shujima/type-c-card/schematic.pdf

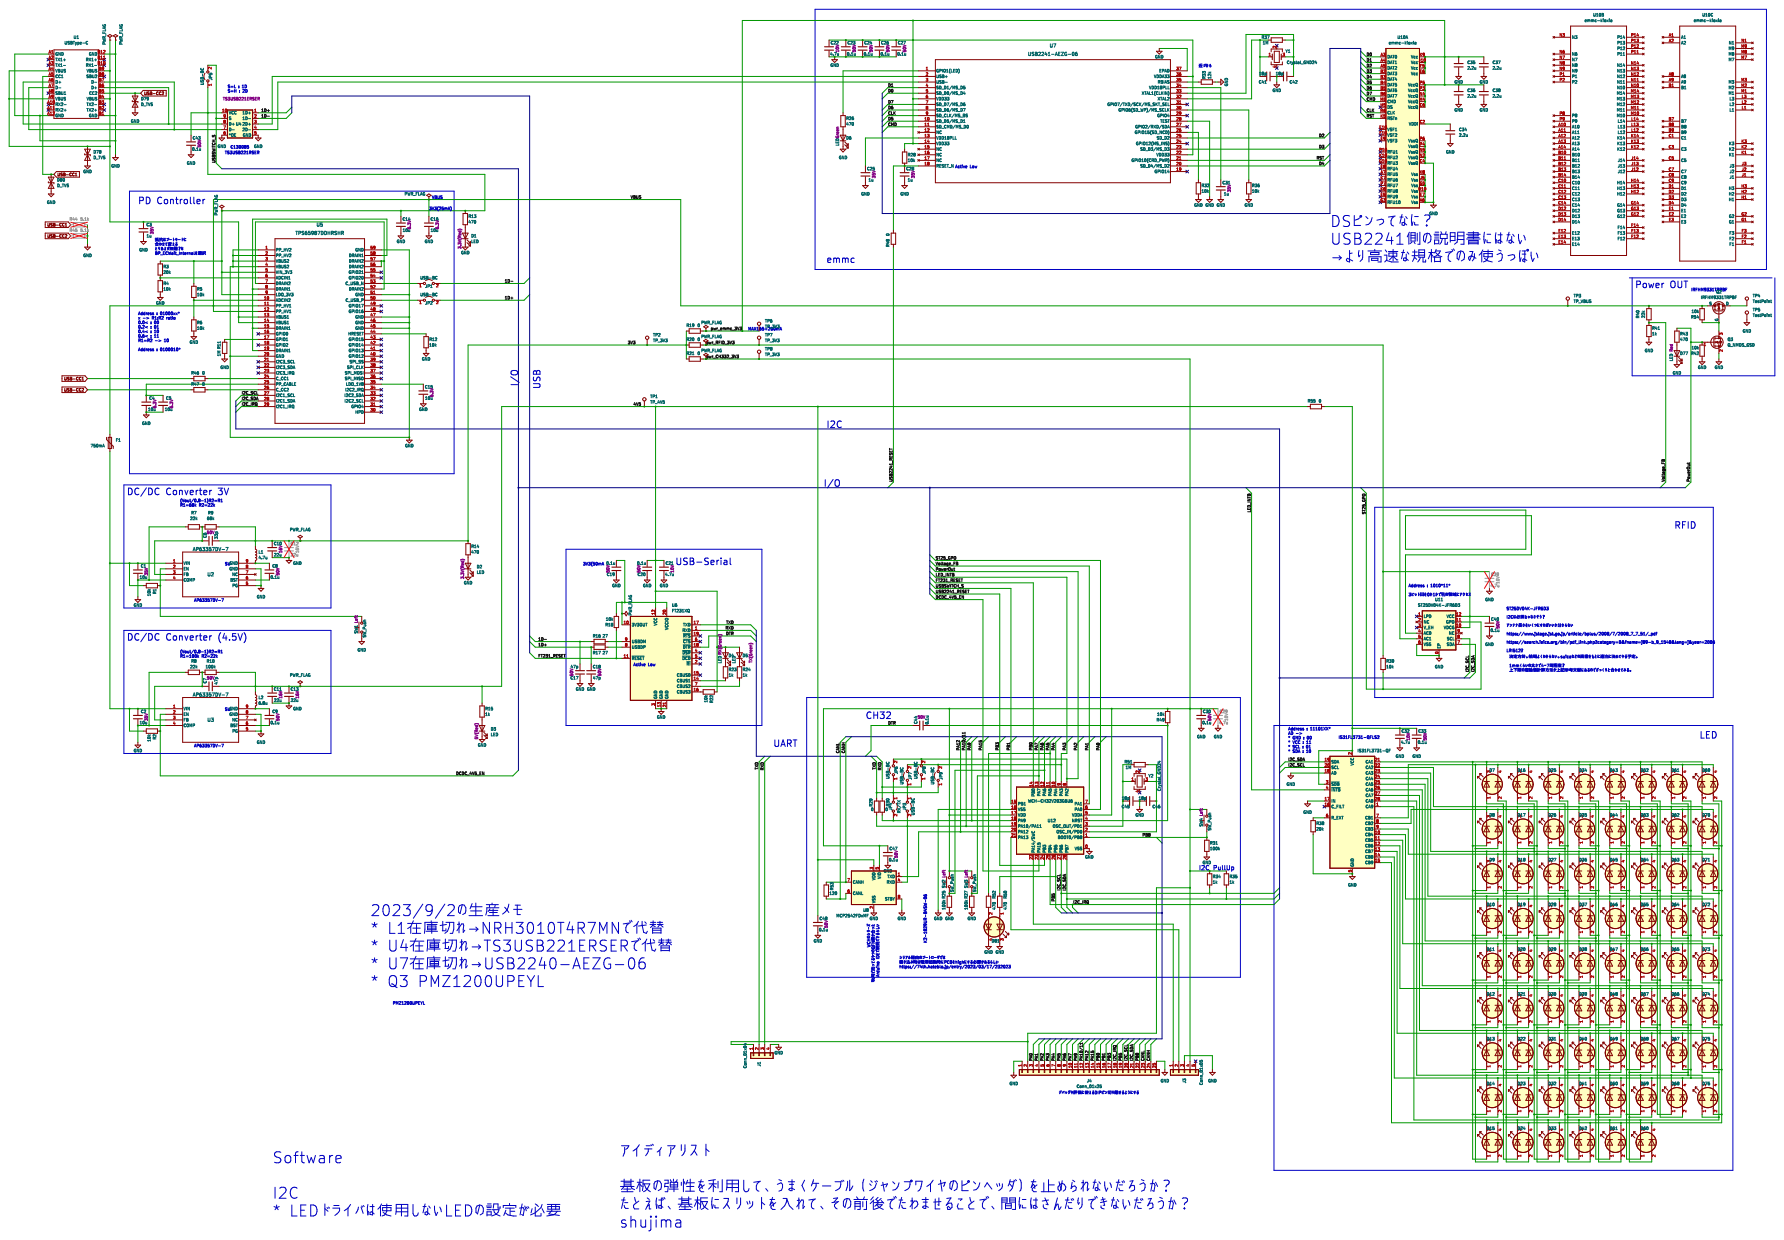
[picture p6: page 1]
