shujima/type-c-card/hardware/sample/type-c-card_lexxpluss_2023/exports/type-c-card_lexxpluss_2023.pdf

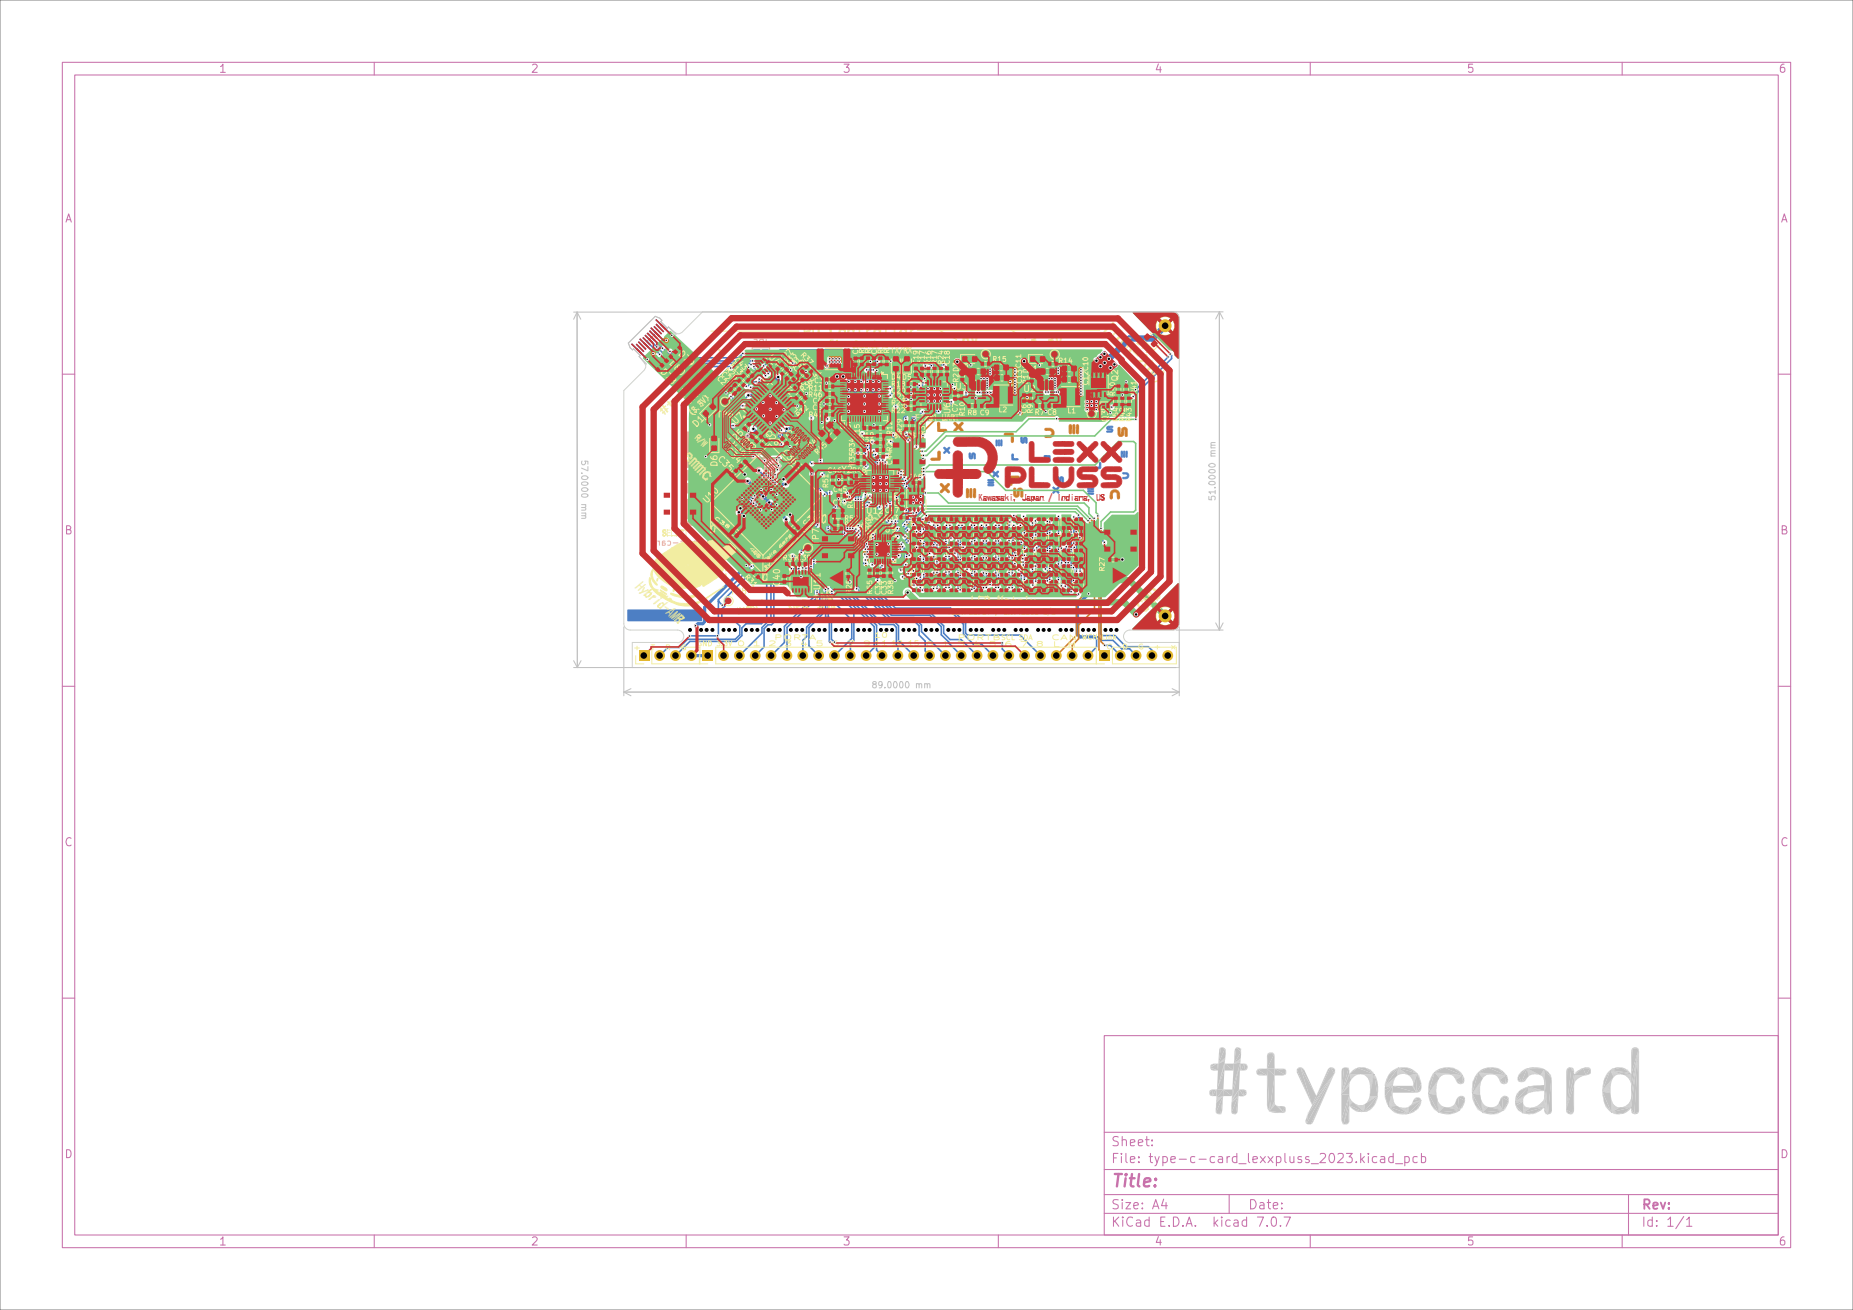
[picture p7: page 1]
