shujima/type-c-card/hardware/sample/type-c-card_lexxpluss_2023/type-c-card_lexxpluss_2023.kicad_sch

## KiCad design hardware/sample/type-c-card_lexxpluss_2023/type-c-card_lexxpluss_2023.kicad_sch (2023-09-23)

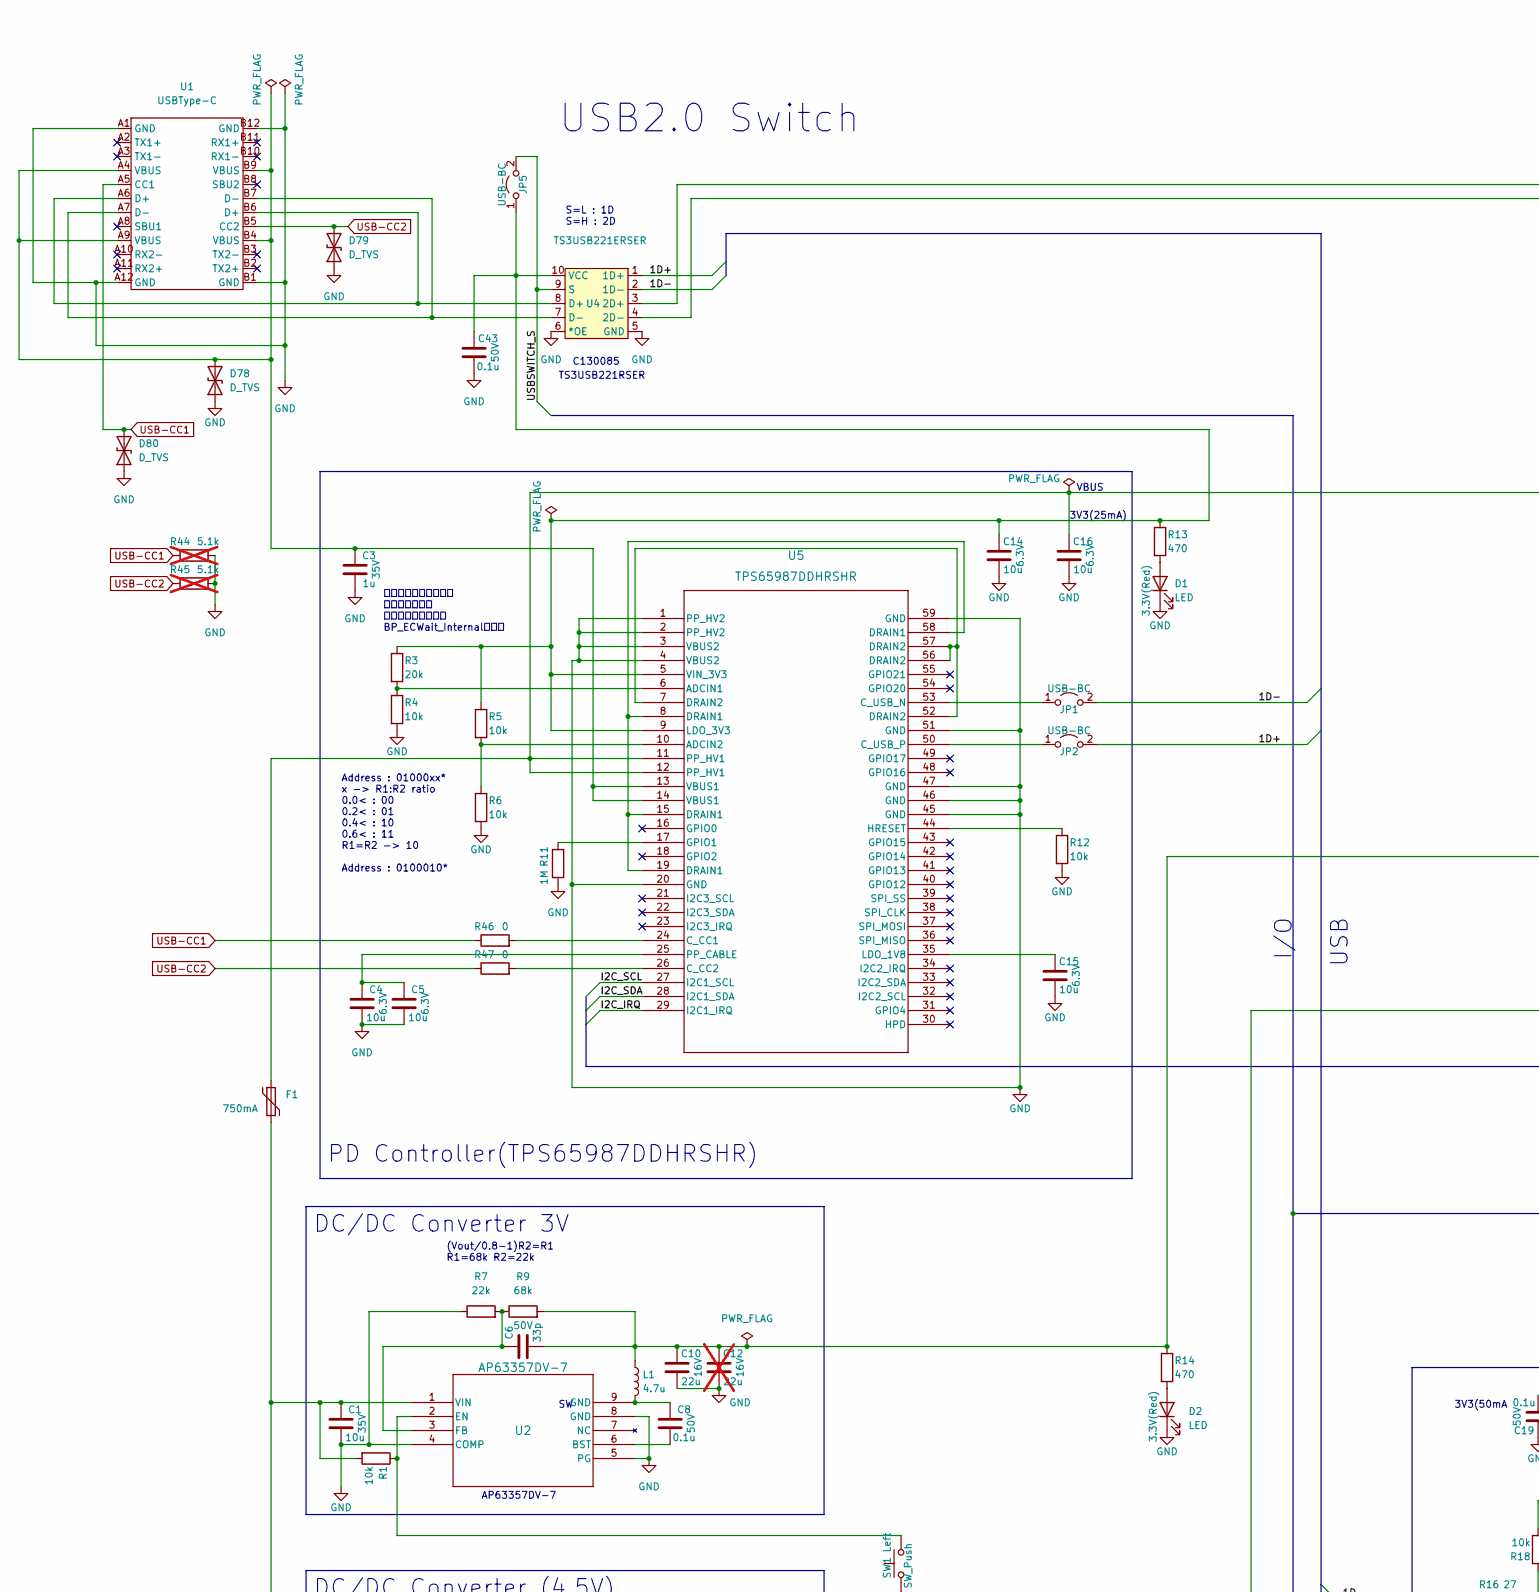
[picture p8: schematic type-c-card_lexxpluss_2023.kicad_sch, part in row 1, column 1]

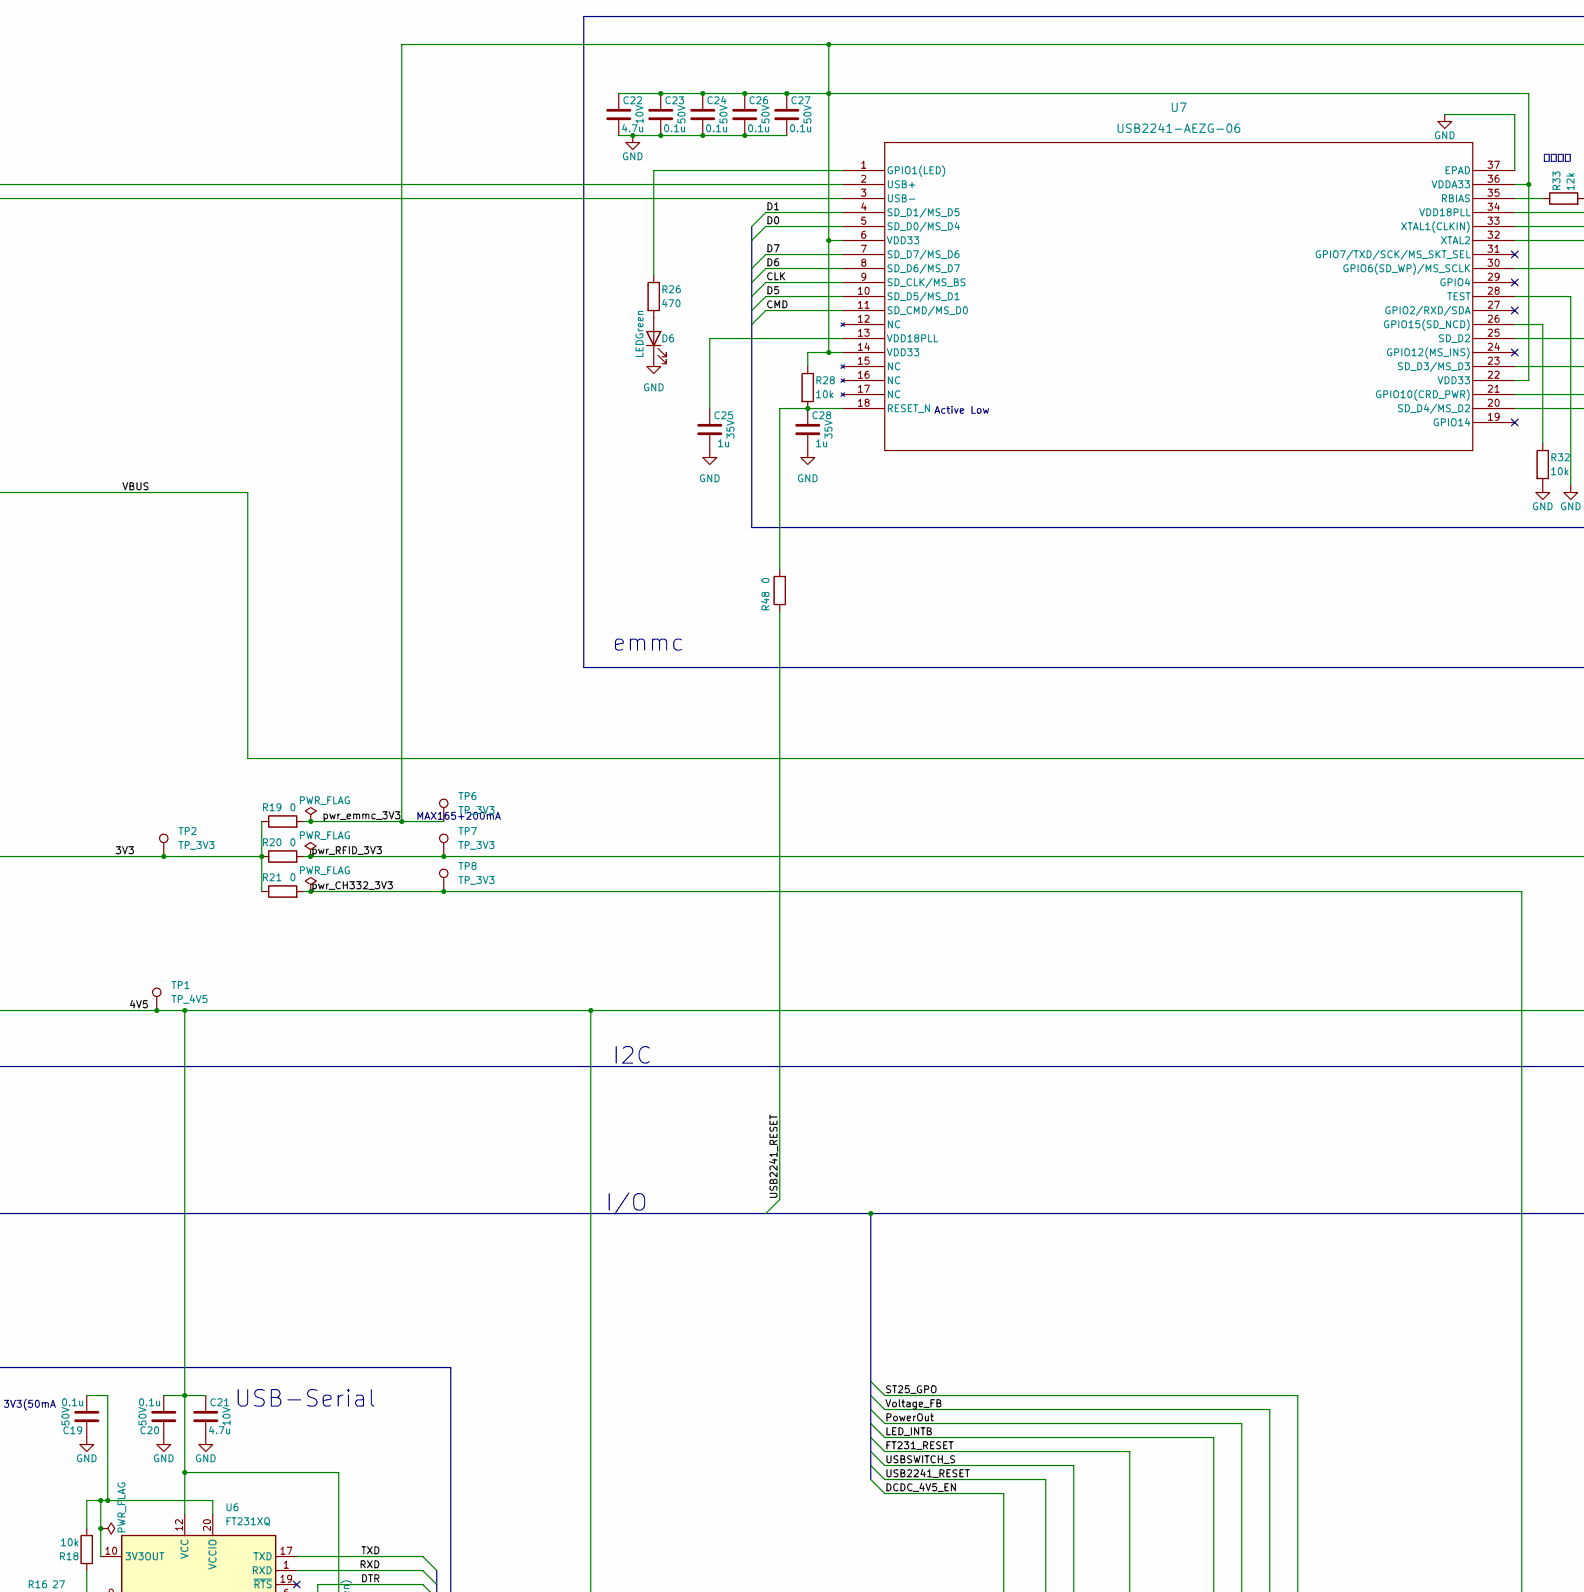
[picture p9: schematic type-c-card_lexxpluss_2023.kicad_sch, part in row 1, column 2]

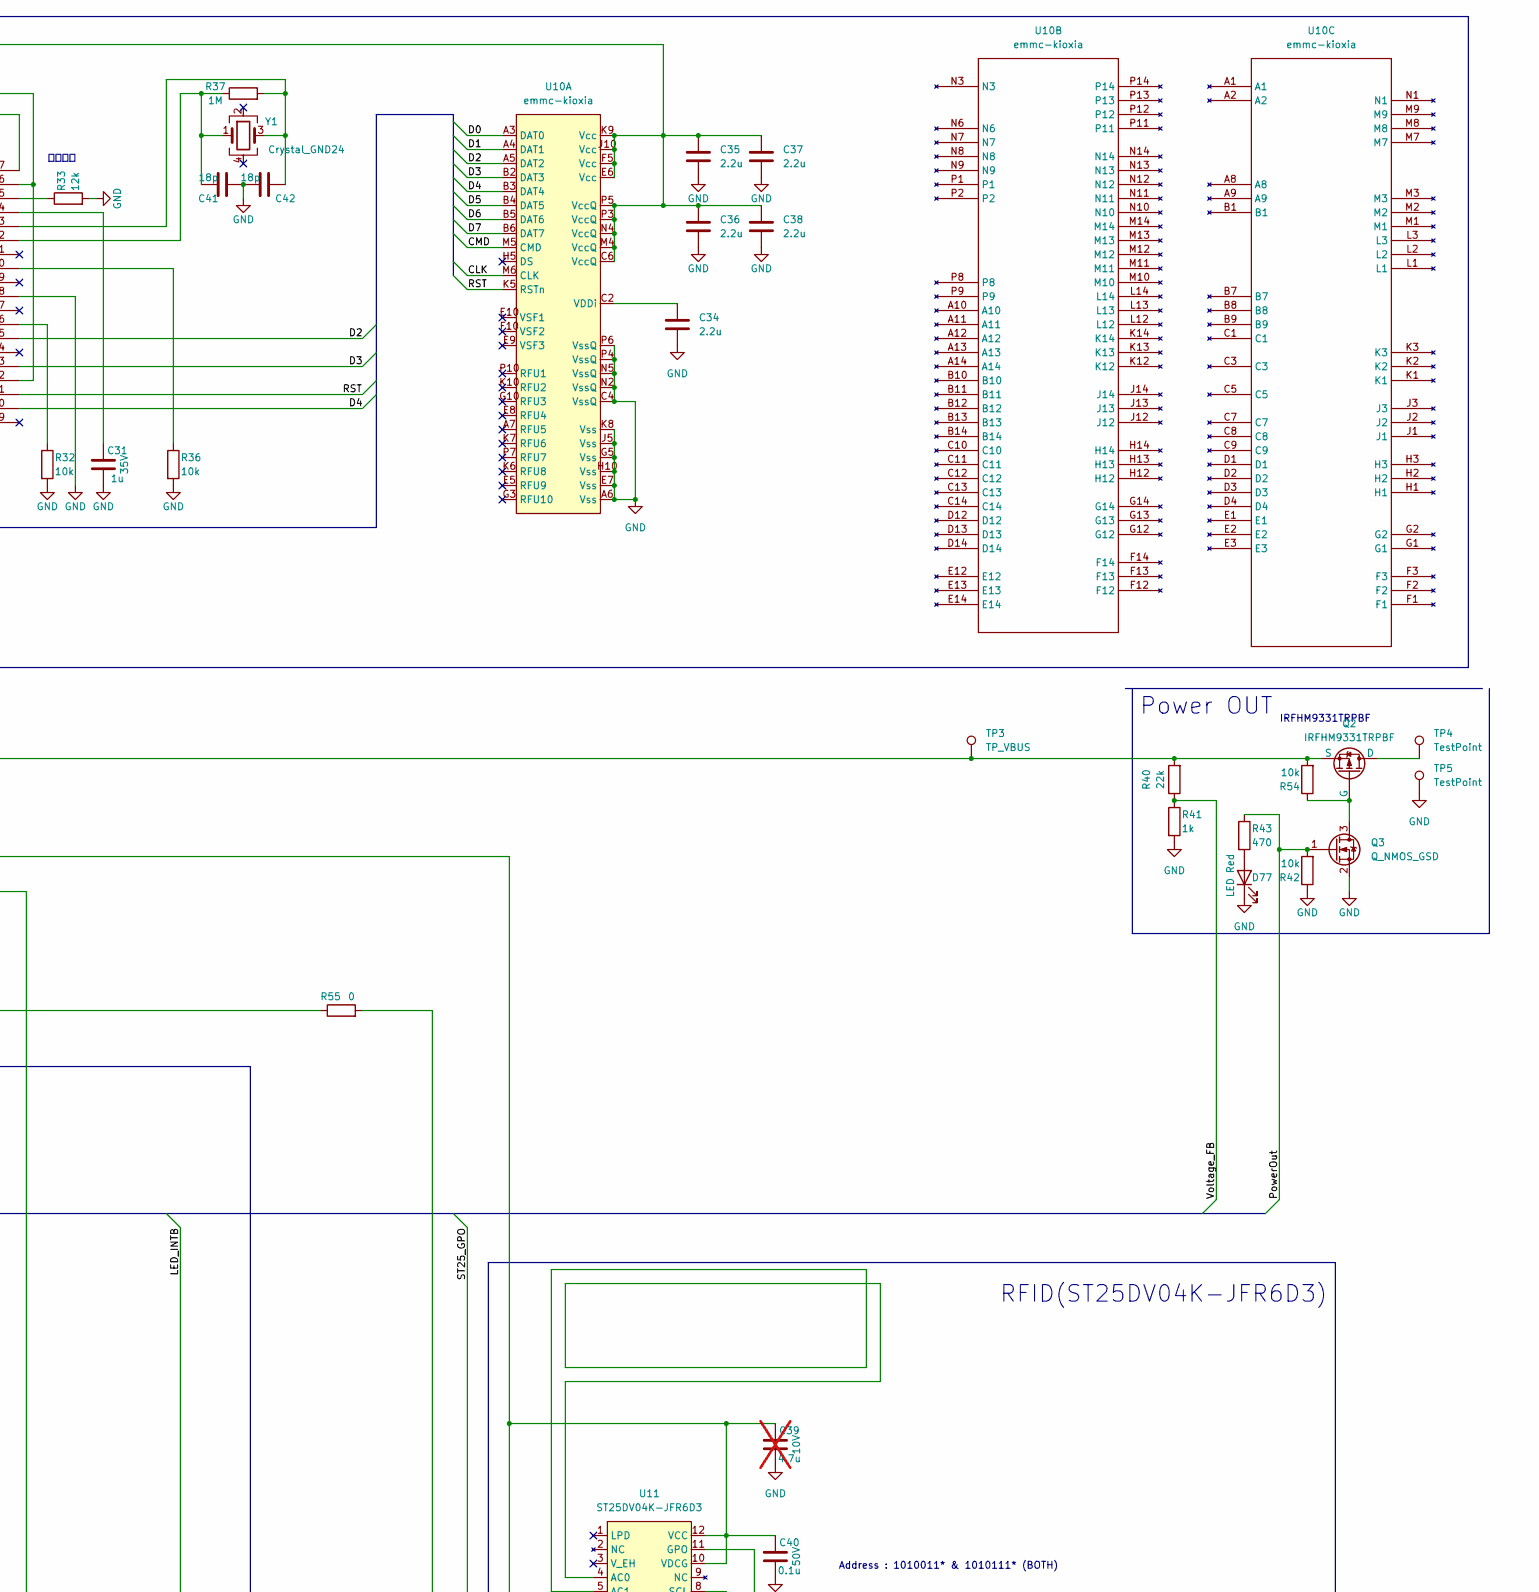
[picture p10: schematic type-c-card_lexxpluss_2023.kicad_sch, part in row 1, column 3]

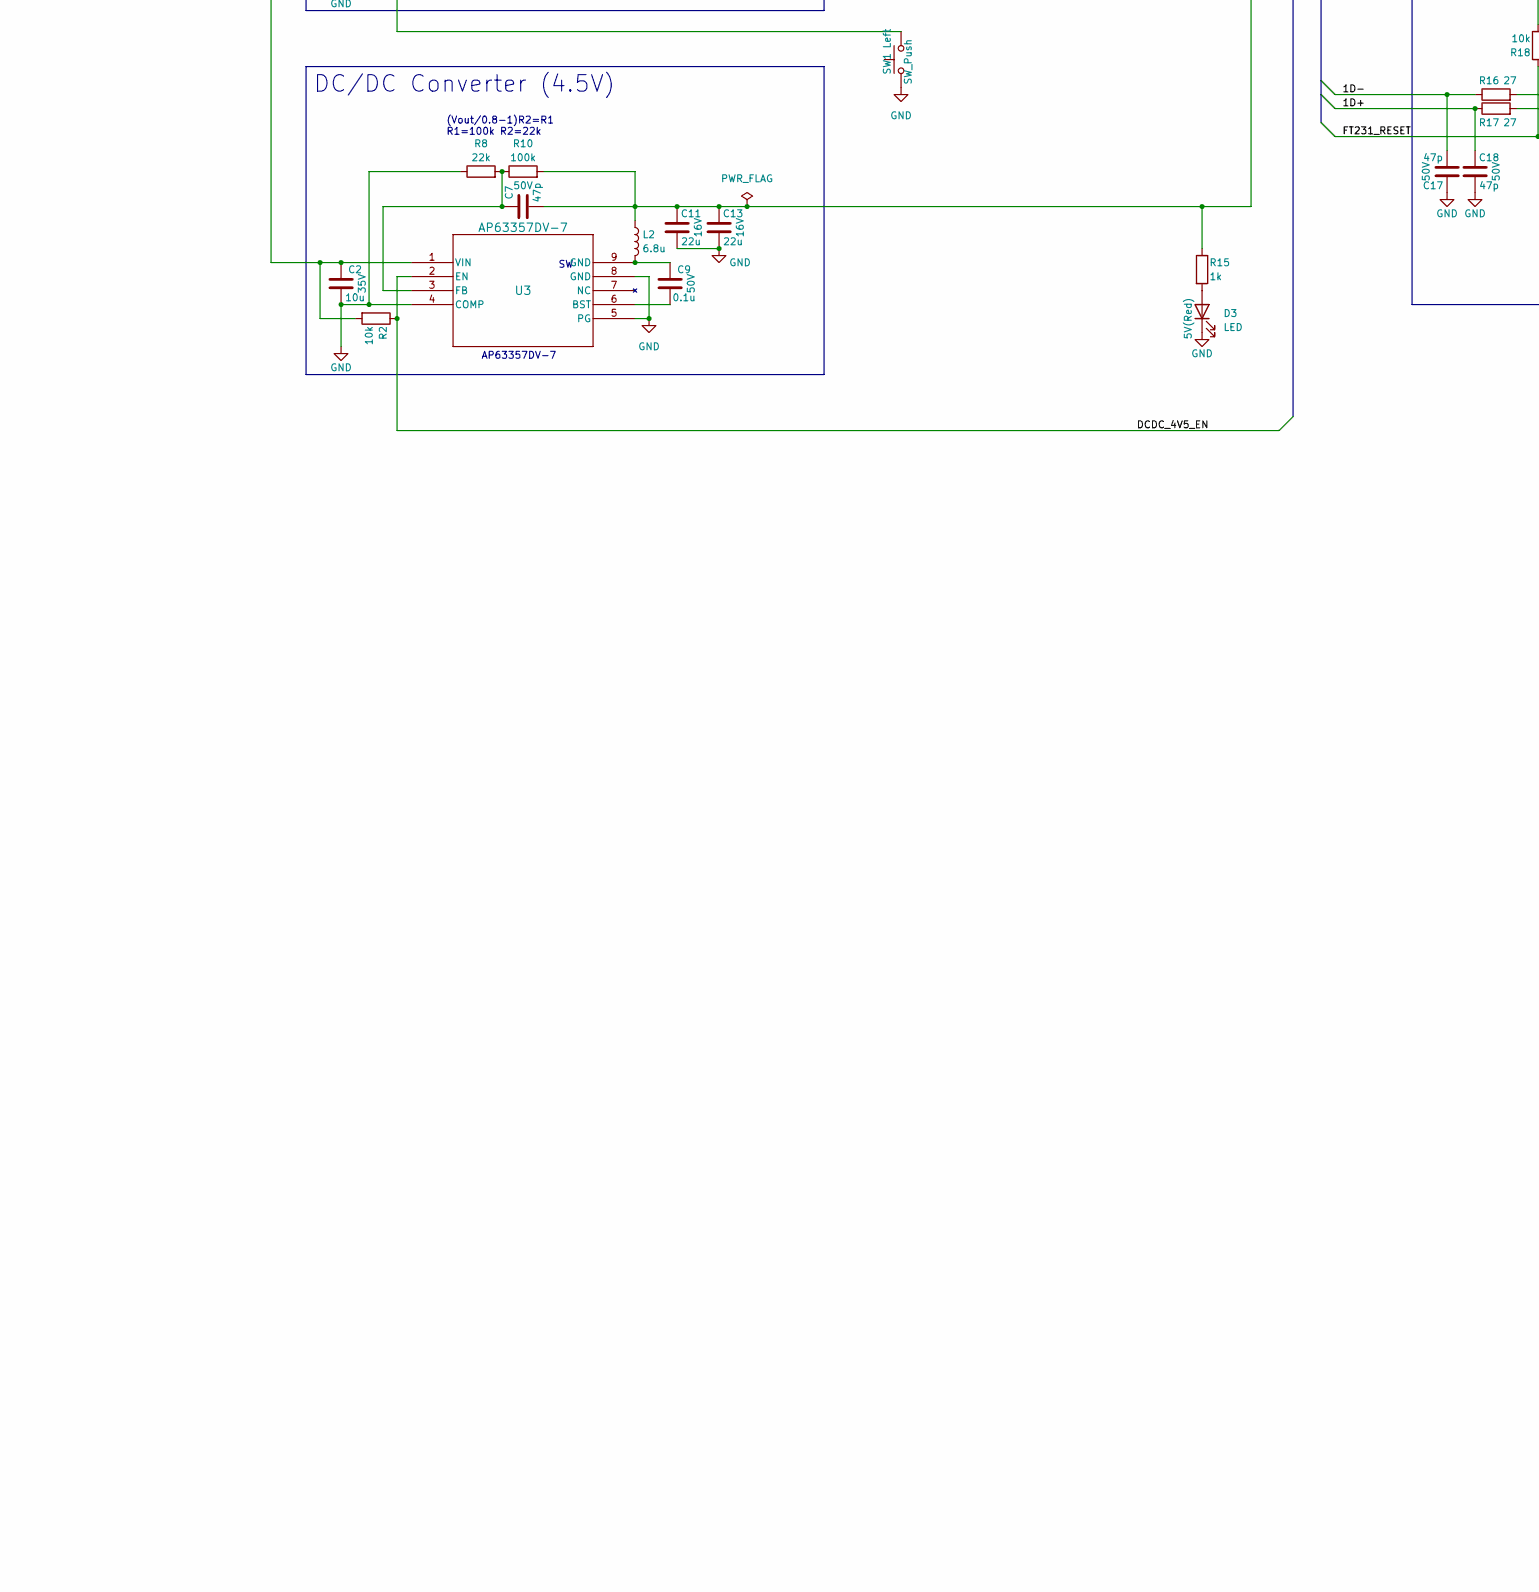
[picture p11: schematic type-c-card_lexxpluss_2023.kicad_sch, part in row 2, column 1]

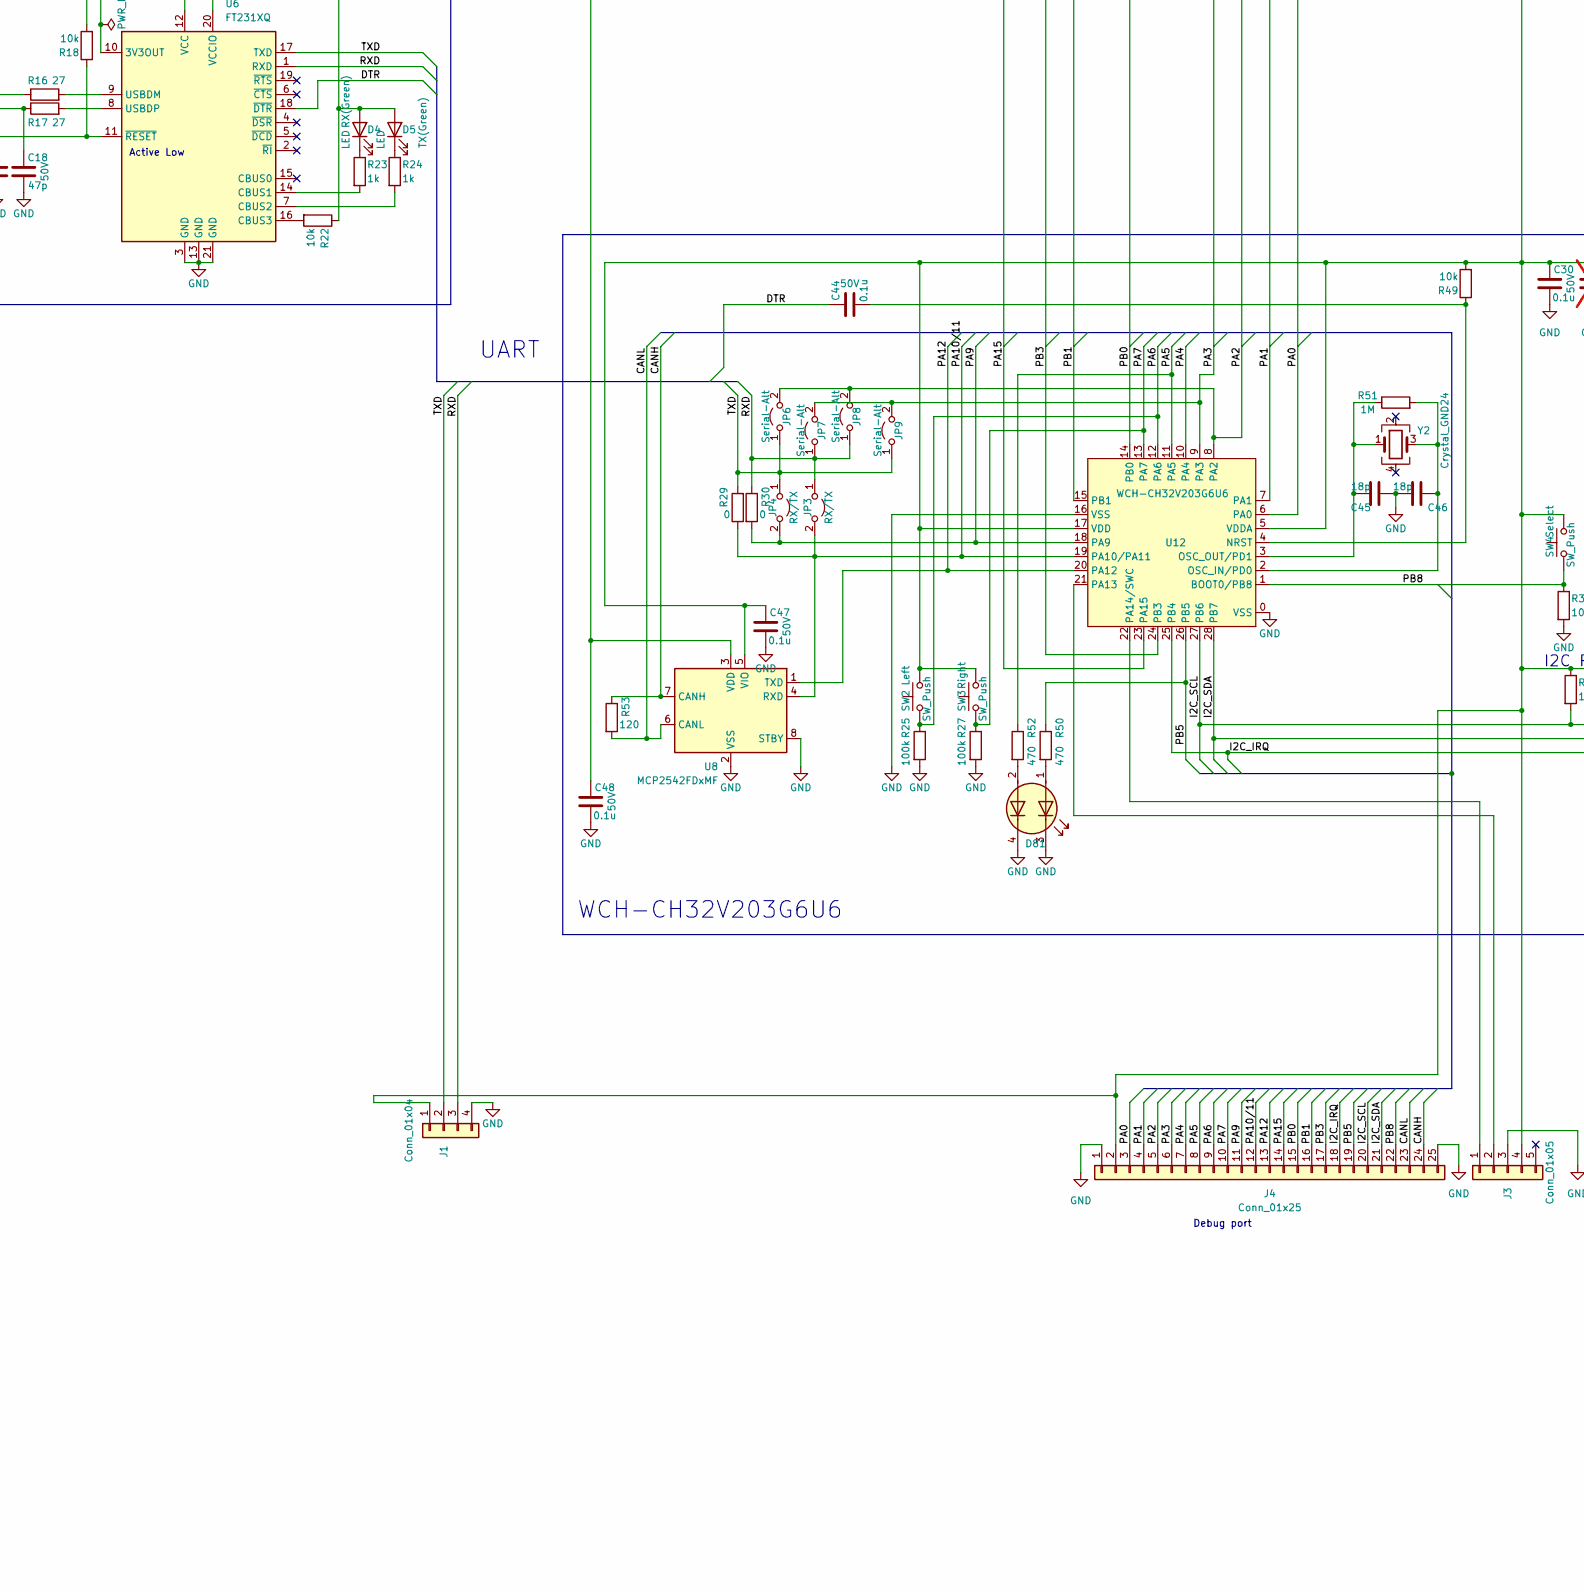
[picture p12: schematic type-c-card_lexxpluss_2023.kicad_sch, part in row 2, column 2]

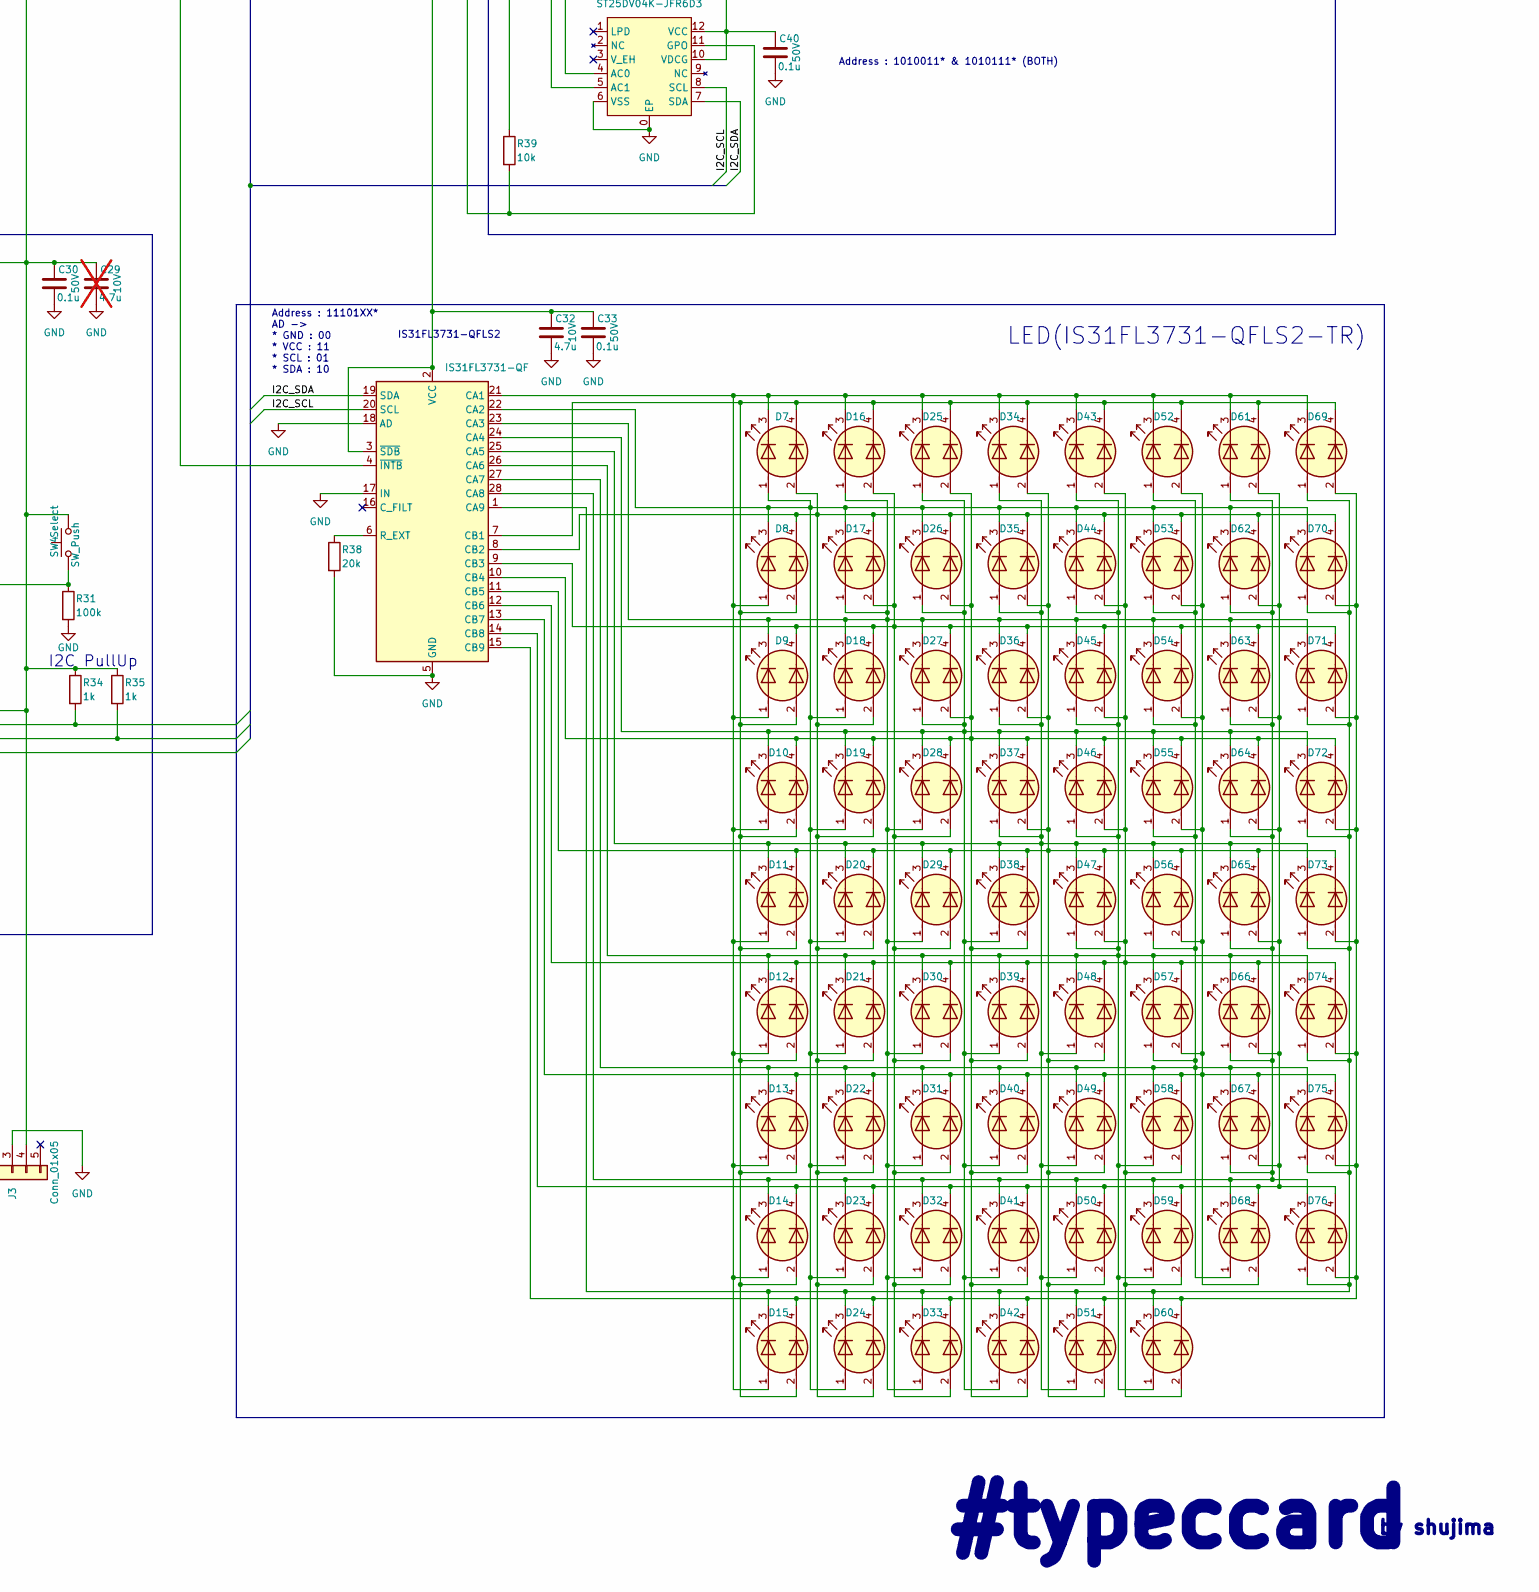
[picture p13: schematic type-c-card_lexxpluss_2023.kicad_sch, part in row 2, column 3]

Parts:
C1, C2: 10u; C_0603_1608Metric; MPN GRM188R6YA106MA73D; LCSC C194427
C3, C25, C28, C31: 1u; C_0402_1005Metric; MPN CL05A105KL5NRNC; LCSC C307413
C4, C5, C14, C15, C16: 10u; C_0402_1005Metric; MPN CL05A106MQ5NUNC; LCSC C15525
C6: 33p; C_0402_1005Metric; MPN GRM1555C1H330GA01D; LCSC C162097
C7, C17, C18: 47p; C_0402_1005Metric; MPN GRM1555C1H470JA01D; LCSC C76970
C8, C9, C19, C20, C23, C24, C26, C27, C30, C33, C40, C43, C44, C47, C48: 0.1u; C_0402_1005Metric; MPN CL05B104KB54PNC; LCSC C307331
C10, C11, C13: 22u; C_0603_1608Metric; MPN CL10A226MO7JZNC; LCSC C2762594
C12: 22u; C_0603_1608Metric; MPN CL10A226MO7JZNC; LCSC C2762594; not fitted
C21, C22, C32: 4.7u; C_0402_1005Metric; MPN CL05A475MP5NRNC; LCSC C23733
C29, C39: 4.7u; C_0402_1005Metric; MPN CL05A475MP5NRNC; LCSC C23733; not fitted
C34, C35, C36, C37, C38: 2.2u; C_0402_1005Metric; MPN CL05A225MQ5NSNC; LCSC C12530
C41, C42, C45, C46: 18p; C_0402_1005Metric; MPN GRM1555C1H180JA01D; LCSC C33149
D1, D2, D3: LED; LED_0603_1608Metric; MPN XL-1608SURC-06; LCSC C965799
D4, D5, D6: LED; LED_0603_1608Metric; MPN XL-1608UGC-04; LCSC C965804
D7, D8, D9, D10, D11, D12, D13, D14, D15, D16, D17, D18, D19, D20, D21, D22, D23, D24, D25, D26, D27, D28, D29, D30, D31, D32, D33, D34, D35, D36, D37, D38, D39, D40, D41, D42, D43, D44, D45, D46, D47, D48, D49, D50, D51, D52, D53, D54, D55, D56, D57, D58, D59, D60, D61, D62, D63, D64, D65, D66, D67, D68, D69, D70, D71, D72, D73, D74, D75, D76, D81: LED_Dual_AAKK; MHT194UGBCT; MPN MHT194UGBCT; LCSC C2764896
D77: LED; LED_0603_1608Metric; MPN XL-1608SURC-06; LCSC C965804
D78, D79, D80: D_TVS; Fuse_0402_1005Metric; MPN XGD10402KR; LCSC C207289
F1: 750mA; Fuse_1812_4532Metric; MPN MF-MSMF075/24-2; LCSC C208467
J1: Conn_01x04; PinHeader_1x04_P2.54mm_Vertical
J3: Conn_01x05; PinHeader_1x05_P2.54mm_Vertical
J4: Conn_01x25; PinHeader_1x25_P2.54mm_Vertical
JP1, JP2, JP5: USB-BC; SolderJumper-2_P1.3mm_Open_TrianglePad1.0x1.5mm
JP3, JP4: RX/TX; SolderJumper-2_P1.3mm_Open_TrianglePad1.0x1.5mm
JP6, JP7, JP8, JP9: Serial-Alt; SolderJumper-2_P1.3mm_Open_TrianglePad1.0x1.5mm
L1: 4.7u; L_Taiyo-Yuden_NR-30xx; MPN NRH3010T4R7MN; LCSC C223112
L2: 6.8u; L_Taiyo-Yuden_NR-30xx; MPN NR3010T6R8M; LCSC C87167
Q2: IRFHM9331TRPBF; IRFHM9331PbF; MPN IRFHM9331TRPBF; LCSC C148156
Q3: Q_NMOS_GSD; SOT-883; MPN PMZ1200UPEYL; LCSC C547279
R1, R2, R4, R5, R6, R12, R18, R22, R28, R32, R36, R39, R42, R49, R54: 10k; R_0402_1005Metric; MPN 0402WGF1002TCE; LCSC C25744
R3, R38: 20k; R_0402_1005Metric; MPN 0402WGF2002TCE; LCSC C25765
R7, R8, R40: 22k; R_0402_1005Metric; MPN 0402WGF2202TCE; LCSC C25768
R9: 68k; R_0402_1005Metric; MPN 0402WGF6802TCE; LCSC C36871
R10, R25, R27, R31: 100k; R_0402_1005Metric; MPN 0402WGF1003TCE; LCSC C25741
R11, R37, R51: 1M; R_0402_1005Metric; MPN 0402WGF1004TCE; LCSC C26083
R13, R14, R26, R43, R50, R52: 470; R_0402_1005Metric; MPN 0402WGF4700TCE; LCSC C25117
R15, R23, R24, R34, R35, R41: 1k; R_0402_1005Metric; MPN 0402WGF1001TCE; LCSC C11702
R16, R17: 27; R_0402_1005Metric; MPN 0402WGF274JTCE; LCSC C31439
R19, R20, R21, R29, R30, R46, R47, R48, R55: 0; R_0402_1005Metric; MPN 0402WGF0000TCE; LCSC C17168
R33: 12k; R_0402_1005Metric; MPN 0402WGF1202TCE; LCSC C25752
R44, R45: 5.1k; R_0603_1608Metric_Pad0.98x0.95mm_HandSolder; MPN 0603WAF5101T5E; LCSC C23186; not fitted
R53: 120; R_0402_1005Metric; MPN 0402WGF1200TCE; LCSC C25079
SW1, SW2, SW3, SW4: SW_Push; Switch_Tact_TS-1059U-B3; MPN K2-1829UR-B4SW-06; LCSC C145870
TP1: TP_4V5; TestPoint_Pad_D1.0mm
TP2, TP6, TP7, TP8: TP_3V3; TestPoint_Pad_D1.0mm
TP3: TP_VBUS; TestPoint_Pad_D1.0mm
TP4, TP5: TestPoint; TestPoint_Loop_D1.80mm_Drill1.0mm_Beaded
U1: USBType-C
U2, U3: AP63357DV-7; V-DFN3020-13_DIO; MPN AP63357DV-7; LCSC C2158014
U4: Texas_UQFN-10_1.5x2mm_P0.5mm; MPN TS3USB221ERSER; LCSC C129313
U5: TPS65987DDHRSHR; RSH56_7P15X7P15_TEX; MPN TPS65987DDHRSHR; LCSC C2868843
U6: FT231XQ; QFN-20-1EP_4x4mm_P0.5mm_EP2.5x2.5mm; MPN FT231XQ-R; LCSC C132159
U7: USB2241-AEZG-06; QFN36_6X6MC_MCH; MPN USB2240-AEZG-06; LCSC C633328
U8: MCP2542FDxMF; DFN-8-1EP_3x3mm_P0.65mm_EP1.55x2.4mm; MPN MCP2542FDT-E/MF; LCSC C623190
U9: IS31FL3731-QF; QFN-28-1EP_4x4mm_P0.4mm_EP2.3x2.3mm; MPN IS31FL3731-QFLS2-TR; LCSC C191206
U10: emmc-kioxia; BGA_NG5D1LBAIL_TRAY_TOS; MPN THGBMNG5D1LBAIL; LCSC C391255
U11: ST25DV04K-JFR6D3; MPN ST25DV04K-JFR6D3; LCSC C2654815
U12: WCH-CH32V203G6U6
Y1, Y2: Crystal_GND24; Seiko-Epson-X1E0002510046; MPN X1E0002510046; LCSC C255976

Connections:
1D+: C18.1, JP2.2 (B), R17.1, U4.1 (1D+)
1D-: C17.2, JP1.2 (B), R16.1, U4.2 (1D-)
3V3: C6.2, C10.1, C12.1, L1.1, R9.2, R14.1, R19.1, R20.1, R21.1, TP2.1
4V5: C7.2, C11.1, C13.1, C20.2, C21.1, C48.1, D4.2 (A), D5.2 (A), L2.1, R10.2, R15.1, R22.1, R55.1, TP1.1, U6.12 (VCC), U8.3 (VDD)
CANH: J4.24, R53.1, U8.7 (CANH)
CANL: J4.23, R53.2, U8.6 (CANL)
CLK: U7.9 (SD_CLK/MS_BS), U10.M6 (CLK)
CMD: U7.11 (SD_CMD/MS_D0), U10.M5 (CMD)
D0: U7.5 (SD_D0/MS_D4), U10.A3 (DAT0)
D1: U7.4 (SD_D1/MS_D5), U10.A4 (DAT1)
D2: U7.25 (SD_D2), U10.A5 (DAT2)
D3: U7.23 (SD_D3/MS_D3), U10.B2 (DAT3)
D4: U7.20 (SD_D4/MS_D2), U10.B3 (DAT4)
D5: U7.10 (SD_D5/MS_D1), U10.B4 (DAT5)
D6: U7.8 (SD_D6/MS_D7), U10.B5 (DAT6)
D7: U7.7 (SD_D7/MS_D6), U10.B6 (DAT7)
DCDC_4V5_EN: J4.14, R2.1, U3.2 (EN), U12.23 (PA15)
DTR: C44.1, U6.18 (~DTR)
FT231_RESET: J4.15, R18.1, U6.11 (~RESET), U12.14 (PB0)
GND: C1.2, C2.2, C3.2, C4.2, C5.2, C10.2, C11.2, C12.2, C13.2, C14.2, C15.2, C16.2, C17.1, C18.2, C19.1, C20.1, C21.2, C22.2, C23.2, C24.2, C25.2, C26.2, C27.2, C28.2, C29.2, C30.2, C31.2, C32.2, C33.2, C34.2, C35.2, C36.2, C37.2, C38.2, C39.2, C40.2, C41.2, C42.1, C43.2, C45.2, C46.1, C47.2, C48.2, D1.1 (K), D2.1 (K), D3.1 (K), D6.1 (K), D77.1 (K), D78.1 (A1), D79.1 (A1), D80.1 (A1), D81.3 (K1), D81.4 (K2), J1.4, J3.3, J4.1, J4.25, Q3.2 (S), R4.2, R6.2, R7.1, R8.1, R11.1, R12.2, R25.2, R27.2, R31.2, R32.2, R33.2, R36.2, R38.2, R41.2, R42.1, R44.2, R45.2, SW1.1, TP5.1, U1.A1 (GND), U1.A12 (GND), U1.B1 (GND), U1.B12 (GND), U2.4 (COMP), U2.5 (PG), U2.8 (GND), U3.4 (COMP), U3.5 (PG), U3.8 (GND), U4.5 (GND), U4.6 (*OE), U5.1 (PP_HV2), U5.2 (PP_HV2), U5.3 (VBUS2), U5.4 (VBUS2), U5.20 (GND), U5.45 (GND), U5.46 (GND), U5.47 (GND), U5.51 (GND), U5.59 (GND), U6.3 (GND), U6.13 (GND), U6.21 (GND), U7.28 (TEST), U7.37 (EPAD), U8.2 (VSS), U8.8 (STBY), U8.9 (VSS), U9.5 (GND), U9.17 (IN), U9.18 (AD), U9.29 (GND), U10.A6 (Vss), U10.C4 (VssQ), U10.E7 (Vss), U10.G5 (Vss), U10.H10 (Vss), U10.J5 (Vss), U10.K8 (Vss), U10.N2 (VssQ), U10.N5 (VssQ), U10.P4 (VssQ), U10.P6 (VssQ), U11.0 (EP), U11.6 (VSS), U12.0 (VSS), U12.16 (VSS)
I2C_IRQ: J4.18, U5.29 (I2C1_IRQ), U12.25 (PB4)
I2C_SCL: J4.20, R34.2, U5.27 (I2C1_SCL), U9.20 (SCL), U11.8 (SCL), U12.27 (PB6)
I2C_SDA: J4.21, R35.2, U5.28 (I2C1_SDA), U9.19 (SDA), U11.7 (SDA), U12.28 (PB7)
LED_INTB: J4.6, JP7.2 (B), JP9.2 (B), U9.4 (~INTB), U12.9 (PA3)
unnamed: C1.1, C2.1, F1.2, R1.2, R2.2, U2.1 (VIN), U3.1 (VIN)
unnamed: C3.1, D78.2 (A2), U1.A4 (VBUS), U1.A9 (VBUS), U1.B4 (VBUS), U1.B9 (VBUS), U5.13 (VBUS1), U5.14 (VBUS1)
unnamed: C4.1, C5.1, U5.25 (PP_CABLE)
unnamed: C6.1, R7.2, R9.1, U2.3 (FB)
unnamed: C7.1, R8.2, R10.1, U3.3 (FB)
unnamed: C8.1, L1.2, U2.9 (GND)
unnamed: C8.2, U2.6 (BST)
unnamed: C9.1, L2.2, U3.9 (GND)
unnamed: C9.2, U3.6 (BST)
unnamed: C14.1, C43.1, JP5.1 (A), R3.1, R5.1, R13.1, U4.10 (VCC), U5.5 (VIN_3V3), U5.9 (LDO_3V3)
unnamed: C15.1, U5.35 (LDO_1V8)
unnamed: C19.2, R18.2, U6.10 (3V3OUT), U6.20 (VCCIO)
unnamed: C25.1, U7.13 (VDD18PLL)
unnamed: C28.1, R28.2, R48.2, U7.18 (RESET_N)
unnamed: C31.1, U7.34 (VDD18PLL)
unnamed: C32.1, C33.1, R55.2, U9.2 (VCC), U9.3 (~SDB)
unnamed: C34.1, U10.C2 (VDDi)
unnamed: C41.1, R37.1, U7.32 (XTAL2), Y1.1
unnamed: C42.2, R37.2, U7.33 (XTAL1(CLKIN)), Y1.3
unnamed: C44.2, R49.1, U12.4 (NRST)
unnamed: C45.1, R51.1, U12.3 (OSC_OUT/PD1), Y2.1
unnamed: C46.2, R51.2, U12.2 (OSC_IN/PD0), Y2.3
unnamed: D1.2 (A), R13.2
unnamed: D2.2 (A), R14.2
unnamed: D3.2 (A), R15.2
unnamed: D4.1 (K), R23.1
unnamed: D5.1 (K), R24.1
unnamed: D6.2 (A), R26.2
unnamed: D7.3 (K1), D8.1 (A1), D9.1 (A1), D10.1 (A1), D11.1 (A1), D12.1 (A1), D13.1 (A1), D14.1 (A1), D15.1 (A1), D16.3 (K1), D25.3 (K1), D34.3 (K1), D43.3 (K1), D52.3 (K1), D61.3 (K1), D69.3 (K1), U9.21 (CA1)
unnamed: D7.4 (K2), D8.2 (A2), D9.2 (A2), D10.2 (A2), D11.2 (A2), D12.2 (A2), D13.2 (A2), D14.2 (A2), D15.2 (A2), D16.4 (K2), D25.4 (K2), D34.4 (K2), D43.4 (K2), D52.4 (K2), D61.4 (K2), D69.4 (K2), U9.7 (CB1)
unnamed: D10.3 (K1), D19.3 (K1), D25.1 (A1), D26.1 (A1), D27.1 (A1), D28.3 (K1), D37.3 (K1), D38.1 (A1), D39.1 (A1), D40.1 (A1), D41.1 (A1), D42.1 (A1), D46.3 (K1), D55.3 (K1), D64.3 (K1), D72.3 (K1), U9.24 (CA4)
unnamed: D10.4 (K2), D19.4 (K2), D25.2 (A2), D26.2 (A2), D27.2 (A2), D28.4 (K2), D37.4 (K2), D38.2 (A2), D39.2 (A2), D40.2 (A2), D41.2 (A2), D42.2 (A2), D46.4 (K2), D55.4 (K2), D64.4 (K2), D72.4 (K2), U9.10 (CB4)
unnamed: D11.3 (K1), D20.3 (K1), D29.3 (K1), D34.1 (A1), D35.1 (A1), D36.1 (A1), D37.1 (A1), D38.3 (K1), D47.3 (K1), D48.1 (A1), D49.1 (A1), D50.1 (A1), D51.1 (A1), D56.3 (K1), D65.3 (K1), D73.3 (K1), U9.25 (CA5)
unnamed: D11.4 (K2), D20.4 (K2), D29.4 (K2), D34.2 (A2), D35.2 (A2), D36.2 (A2), D37.2 (A2), D38.4 (K2), D47.4 (K2), D48.2 (A2), D49.2 (A2), D50.2 (A2), D51.2 (A2), D56.4 (K2), D65.4 (K2), D73.4 (K2), U9.11 (CB5)
unnamed: D12.3 (K1), D21.3 (K1), D30.3 (K1), D39.3 (K1), D43.1 (A1), D44.1 (A1), D45.1 (A1), D46.1 (A1), D47.1 (A1), D48.3 (K1), D57.3 (K1), D58.1 (A1), D59.1 (A1), D60.1 (A1), D66.3 (K1), D74.3 (K1), U9.26 (CA6)
unnamed: D12.4 (K2), D21.4 (K2), D30.4 (K2), D39.4 (K2), D43.2 (A2), D44.2 (A2), D45.2 (A2), D46.2 (A2), D47.2 (A2), D48.4 (K2), D57.4 (K2), D58.2 (A2), D59.2 (A2), D60.2 (A2), D66.4 (K2), D74.4 (K2), U9.12 (CB6)
unnamed: D13.3 (K1), D22.3 (K1), D31.3 (K1), D40.3 (K1), D49.3 (K1), D52.1 (A1), D53.1 (A1), D54.1 (A1), D55.1 (A1), D56.1 (A1), D57.1 (A1), D58.3 (K1), D67.3 (K1), D68.1 (A1), D75.3 (K1), U9.27 (CA7)
unnamed: D13.4 (K2), D22.4 (K2), D31.4 (K2), D40.4 (K2), D49.4 (K2), D52.2 (A2), D53.2 (A2), D54.2 (A2), D55.2 (A2), D56.2 (A2), D57.2 (A2), D58.4 (K2), D67.4 (K2), D68.2 (A2), D75.4 (K2), U9.13 (CB7)
unnamed: D14.3 (K1), D23.3 (K1), D32.3 (K1), D41.3 (K1), D50.3 (K1), D59.3 (K1), D61.1 (A1), D62.1 (A1), D63.1 (A1), D64.1 (A1), D65.1 (A1), D66.1 (A1), D67.1 (A1), D68.3 (K1), D76.3 (K1), U9.28 (CA8)
unnamed: D14.4 (K2), D23.4 (K2), D32.4 (K2), D41.4 (K2), D50.4 (K2), D59.4 (K2), D61.2 (A2), D62.2 (A2), D63.2 (A2), D64.2 (A2), D65.2 (A2), D66.2 (A2), D67.2 (A2), D68.4 (K2), D76.4 (K2), U9.14 (CB8)
unnamed: D15.3 (K1), D24.3 (K1), D33.3 (K1), D42.3 (K1), D51.3 (K1), D60.3 (K1), D69.1 (A1), D70.1 (A1), D71.1 (A1), D72.1 (A1), D73.1 (A1), D74.1 (A1), D75.1 (A1), D76.1 (A1), U9.1 (CA9)
unnamed: D15.4 (K2), D24.4 (K2), D33.4 (K2), D42.4 (K2), D51.4 (K2), D60.4 (K2), D69.2 (A2), D70.2 (A2), D71.2 (A2), D72.2 (A2), D73.2 (A2), D74.2 (A2), D75.2 (A2), D76.2 (A2), U9.15 (CB9)
unnamed: D9.3 (K1), D16.1 (A1), D17.1 (A1), D18.3 (K1), D27.3 (K1), D28.1 (A1), D29.1 (A1), D30.1 (A1), D31.1 (A1), D32.1 (A1), D33.1 (A1), D36.3 (K1), D45.3 (K1), D54.3 (K1), D63.3 (K1), D71.3 (K1), U9.23 (CA3)
unnamed: D9.4 (K2), D16.2 (A2), D17.2 (A2), D18.4 (K2), D27.4 (K2), D28.2 (A2), D29.2 (A2), D30.2 (A2), D31.2 (A2), D32.2 (A2), D33.2 (A2), D36.4 (K2), D45.4 (K2), D54.4 (K2), D63.4 (K2), D71.4 (K2), U9.9 (CB3)
unnamed: D7.1 (A1), D8.3 (K1), D17.3 (K1), D18.1 (A1), D19.1 (A1), D20.1 (A1), D21.1 (A1), D22.1 (A1), D23.1 (A1), D24.1 (A1), D26.3 (K1), D35.3 (K1), D44.3 (K1), D53.3 (K1), D62.3 (K1), D70.3 (K1), U9.22 (CA2)
unnamed: D7.2 (A2), D8.4 (K2), D17.4 (K2), D18.2 (A2), D19.2 (A2), D20.2 (A2), D21.2 (A2), D22.2 (A2), D23.2 (A2), D24.2 (A2), D26.4 (K2), D35.4 (K2), D44.4 (K2), D53.4 (K2), D62.4 (K2), D70.4 (K2), U9.8 (CB2)
unnamed: D77.2 (A), R43.2
unnamed: D81.1 (A1), R50.2
unnamed: D81.2 (A2), R52.2
unnamed: J3.1, U12.22 (PA14/SWC)
unnamed: J3.2, U12.21 (PA13)
unnamed: JP1.1 (A), U5.53 (C_USB_N)
unnamed: JP2.1 (A), U5.50 (C_USB_P)
unnamed: Q2.4 (G), Q3.3 (D), R54.1
unnamed: Q2.5 (D), Q2.6 (D), Q2.7 (D), Q2.8 (D), Q2.9 (D), TP4.1
unnamed: R1.1, SW1.2, U2.2 (EN)
unnamed: R3.2, R4.1, U5.6 (ADCIN1)
unnamed: R5.2, R6.1, U5.10 (ADCIN2)
unnamed: R11.2, U5.17 (GPIO1)
unnamed: R12.1, U5.44 (HRESET)
unnamed: R16.2, U6.9 (USBDM)
unnamed: R17.2, U6.8 (USBDP)
unnamed: R22.2, U6.16 (CBUS3)
unnamed: R23.2, U6.14 (CBUS1)
unnamed: R24.2, U6.7 (CBUS2)
unnamed: R26.1, U7.1 (GPIO1(LED))
unnamed: R32.1, U7.26 (GPIO15(SD_NCD))
unnamed: R33.1, U7.35 (RBIAS)
unnamed: R36.1, U7.30 (GPIO6(SD_WP)/MS_SCLK)
unnamed: R38.1, U9.6 (R_EXT)
unnamed: R46.2, U5.24 (C_CC1)
unnamed: R47.2, U5.26 (C_CC2)
unnamed: U1.A6 (D+), U1.B6 (D+), U4.8 (D+)
unnamed: U1.A7 (D-), U1.B7 (D-), U4.7 (D-)
unnamed: U4.3 (2D+), U7.2 (USB+)
unnamed: U4.4 (2D-), U7.3 (USB-)
unnamed: U5.8 (DRAIN1), U5.15 (DRAIN1), U5.19 (DRAIN1), U5.58 (DRAIN1)
unnamed: U5.7 (DRAIN2), U5.52 (DRAIN2), U5.56 (DRAIN2), U5.57 (DRAIN2)
unnamed: U11.4 (AC0), U11.5 (AC1)
PA0: J4.3, R39.2, U11.11 (GPO), U12.6 (PA0)
PA1: J4.4, R40.1, R41.1, U12.7 (PA1)
PA2: J4.5, JP6.2 (B), JP8.2 (B), Q3.1 (G), R42.2, R43.1, U12.8 (PA2)
PA4: J4.7, U12.10 (PA4)
PA5: J4.8, R52.1, U12.11 (PA5)
PA6: J4.9, R25.1, SW2.1, U12.12 (PA6)
PA7: J4.10, R27.1, SW3.1, U12.13 (PA7)
PA9: J4.11, JP4.2 (B), R30.2, U12.18 (PA9)
PA10/11: J4.12, JP3.2 (B), R29.1, U8.4 (RXD), U12.19 (PA10/PA11)
PA12: J4.13, U8.1 (TXD), U12.20 (PA12)
PB1: J4.16, JP5.2 (B), U4.9 (S), U12.15 (PB1)
PB3: J4.17, R48.1, U12.24 (PB3)
PB5: J4.19, R50.1, U12.26 (PB5)
PB8: J4.22, R31.1, SW4.1, U12.1 (BOOT0/PB8)
RST: U7.21 (GPIO10(CRD_PWR)), U10.K5 (RSTn)
RXD: J1.3, JP3.1 (A), JP7.1 (A), JP8.1 (A), R30.1, U6.1 (RXD)
TXD: J1.2, JP4.1 (A), JP6.1 (A), JP9.1 (A), R29.2, U6.17 (TXD)
USB-CC1: D80.2 (A2), R44.1, R46.1, U1.A5 (CC1)
USB-CC2: D79.2 (A2), R45.1, R47.1, U1.B5 (CC2)
VBUS: C16.1, F1.1, Q2.1 (S), Q2.2 (S), Q2.3 (S), Q2.10 (S), R40.2, R54.2, TP3.1, U5.11 (PP_HV1), U5.12 (PP_HV1)
pwr_CH332_3V3: C29.1, C30.1, C47.1, J1.1, J3.4, J4.2, R21.2, R34.1, R35.1, R49.2, SW2.2, SW3.2, SW4.2, TP8.1, U8.5 (VIO), U12.5 (VDDA), U12.17 (VDD)
pwr_RFID_3V3: C39.1, C40.1, R20.2, R39.1, TP7.1, U11.10 (VDCG), U11.12 (VCC)
pwr_emmc_3V3: C22.1, C23.1, C24.1, C26.1, C27.1, C35.1, C36.1, C37.1, C38.1, R19.2, R28.1, TP6.1, U7.6 (VDD33), U7.14 (VDD33), U7.22 (VDD33), U7.36 (VDDA33), U10.C6 (VccQ), U10.E6 (Vcc), U10.F5 (Vcc), U10.J10 (Vcc), U10.K9 (Vcc), U10.M4 (VccQ), U10.N4 (VccQ), U10.P3 (VccQ), U10.P5 (VccQ)

Notes on the sheet:
C130085
DC/DC Converter (4.5V)
IS31FL3731-QFLS2
Debug port
AP63357DV-7
USB-Serial
MAX165+200mA
UART
Address : 01000xx* x -> R1:R2 ratio 0.0< : 00 0.2< : 01 0.4< : 10 0.6< : 11 R1=R2 -> 10 Address : 0100010*
DC/DC Converter 3V
I2C PullUp
RFID(ST25DV04K-JFR6D3)
Address : 11101XX* AD -> * GND : 00 * VCC : 11 * SCL : 01 * SDA : 10
I/O
3V3(25mA)
3V3(50mA
VBUS
IRFHM9331TRPBF
(Vout/0.8-1)R2=R1 R1=100k R2=22k
(Vout/0.8-1)R2=R1 R1=68k R2=22k
Active Low
PD Controller(TPS65987DDHRSHR)
by shujima
抵抗はブートモードに 合わせて変える とりあえず無難？な BP_ECWait_Internalを選択
USB
#typeccard
emmc
Address : 1010011* & 1010111* (BOTH)
S=L : 1D S=H : 2D
LED(IS31FL3731-QFLS2-TR)
近づけろ
WCH-CH32V203G6U6
Power OUT
USB2.0 Switch
TS3USB221RSER
I2C
