shujima/type-c-card/software/sample/MounRiverProject_PD-Controller-I2C/User/main.c

/********************************** (C) COPYRIGHT *******************************
 * File Name          : main.c
 * Author             : shujima
 * Version            : V1.0.0
 * Date               : 2023/10/01
 * Description        : Main program body.
 *********************************************************************************
*/

#include "debug.h"
#include "I2C.h"
#include <stdlib.h>
#include <TC_LED_Matrix.h>

/* Global define */

/* Global Variable */

/*********************************************************************
 * @fn      GPIO_Toggle_INIT
 *
 * @brief   Initializes GPIO of Debug LEDs
 *
 * @return  none
 */
void GPIO_Toggle_INIT(void)
{
    GPIO_InitTypeDef GPIO_InitStructureA = {0};
    GPIO_InitTypeDef GPIO_InitStructureB = {0};

    RCC_APB2PeriphClockCmd(RCC_APB2Periph_GPIOA | RCC_APB2Periph_GPIOB, ENABLE);
    GPIO_InitStructureA.GPIO_Pin = GPIO_Pin_5;
    GPIO_InitStructureA.GPIO_Mode = GPIO_Mode_Out_PP;
    GPIO_InitStructureA.GPIO_Speed = GPIO_Speed_50MHz;
    GPIO_Init(GPIOA, &GPIO_InitStructureA);

    GPIO_InitStructureB.GPIO_Pin = GPIO_Pin_5;
    GPIO_InitStructureB.GPIO_Mode = GPIO_Mode_Out_PP;
    GPIO_InitStructureB.GPIO_Speed = GPIO_Speed_50MHz;
    GPIO_Init(GPIOB, &GPIO_InitStructureB);
}





/*********************************************************************
 * @fn      main
 *
 * @brief   Main program.
 *
 * @return  none
 */
int main(void)
{
    u8 i = 0;

    NVIC_PriorityGroupConfig(NVIC_PriorityGroup_2);
    SystemCoreClockUpdate();
    Delay_Init();
    USART_Printf_Init(115200);
    printf("SystemClk:%d\r\n", SystemCoreClock);
    printf( "ChipID:%08x\r\n", DBGMCU_GetCHIPID() );
    printf("USB PD Demo\r\n");
    GPIO_Toggle_INIT();

    GPIO_WriteBit(GPIOA, GPIO_Pin_5, Bit_SET);
    //GPIO_WriteBit(GPIOA, GPIO_Pin_4, Bit_RESET);

    Delay_Ms(500);

    printf("I2C init\r\n");

    I2C_init();


    u8 buf[20];

    u8 n;
    printf("I2C read start\r\n");

    for( u8 j = 0 ; j < 0x7F ; j ++ )
    {
        n = I2C_read(0b0100010,j,20,buf); // PD address ; kono address dato TRANSMITTERMODE ni naranai
        //n = I2C_read(0b1110100,0,20,buf); //LED address; kono address dato RECEIVERMODE ni naranai

        printf("%4x, %d byte : ",j,n);
        for ( u8 i = 0; i < n ; i ++)
        {
            printf("%d, ",buf[i]);
        }
        printf("\r\n");
    }


    Matrix_init();

    u8 g = 50; // green brightness 0 - 255
    u8 b = 0;   // blue brightness 0 - 255



    //Turn on each LED in order ->->->->->->->->->->->
    //i = vertical pos 0:TOP 4:BOTTOM
    //j = horizontal pos 0:left 13:right
    //GREEN
    for(int j = 0; j < 5 ; j ++)
    {
        for(int k = 0; k < 14 ; k ++)
        {
            Matrix_setBufPixel(j,k,g,b);
            Matrix_writeBufToMatrix(0);

            Delay_Ms(1);

            Matrix_setBufPixel(j,k,0,0);
        }
    }

    g = 0;
    b = 50;

    //BLUE
    for(int k = 0; k < 14 ; k ++)
    {
        for(int j = 0; j < 5 ; j ++)
        {
            Matrix_setBufPixel(j,k,g,b);
            Matrix_writeBufToMatrix(0);

            Delay_Ms(1);
        }
    }

    Matrix_clearBuf();



    //Draw Logo by pixel
    //Green part
    g = 50;
    b = 0;
    Matrix_setBufPixel(3,5,g,b);
    Matrix_setBufPixel(2,6,g,b);
    Matrix_setBufPixel(3,6,g,b);
    Matrix_setBufPixel(4,6,g,b);
    Matrix_setBufPixel(3,7,g,b);
    //Logo P
    //Blue part
    g = 40;
    b = 50;
    Matrix_setBufPixel(1,6,g,b);
    Matrix_setBufPixel(1,7,g,b);
    Matrix_setBufPixel(1,8,g,b);
    Matrix_setBufPixel(2,9,g,b);
    Matrix_setBufPixel(3,8,g,b);

    Matrix_writeBufToMatrix(0); //Drawing


    //Draw String
    u16 p;
    p = Matrix_setBufPrint("I2C LED Display DEMO", 100, 0, 14);
    p = Matrix_setBufPrint("   CH32V203 RISC-V MCU", 0, 100, p);
    p = Matrix_setBufPrint(" + IS31FL3731 CharliePlex Matrix ", 50, 50, p);

    Matrix_writeBufToMatrix(0); //Drawing


    Delay_Ms(500);

    //Flow
    for(u16 offset = 0 ; offset < p ; offset ++)
    {
        Matrix_writeBufToMatrix(offset);
        Delay_Ms(10);
    }


    //Debug LED
    while(1)
    {
        Delay_Ms(1000);
        GPIO_WriteBit(GPIOA, GPIO_Pin_5, (i % 4 == 1 || i % 4 == 2) ? Bit_SET : Bit_RESET);
        GPIO_WriteBit(GPIOB, GPIO_Pin_5, (i % 4 == 2 || i % 4 == 3) ? Bit_RESET : Bit_SET);
        i++;
    }
}
