shujima/type-c-card/(commit log)

2023-09-17 add schematic pdf
2023-09-17 add sample project
2023-09-23 add hardware informations
    [bom.csv, designators.csv, positions.csv, type-c-card_lexxpluss_2023.kicad_sch]
2023-09-30 NOT WORKING, debugging, IS31FL3731_clearFrame() changed 0->255 so it blinks when clear
    [IS31FL3731.h]
2023-10-01 add simple button sample
